FabianKlaffenboeck/Surron_UltraBee_Logger_Hardware/3dmodels/MP1584EN.step

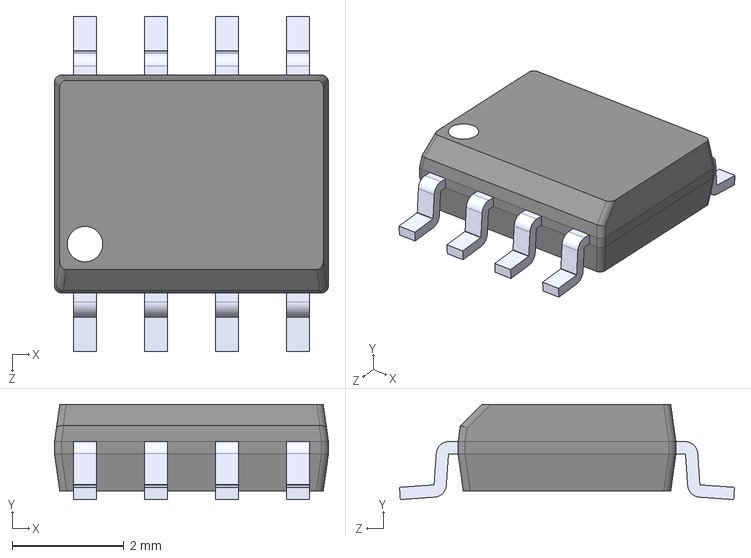
[picture p1: CAD file, 2024-06-30]
3dmodels/MP1584EN.step
4.90 x 1.70 x 5.99 mm
