FabianKlaffenboeck/Surron_UltraBee_Logger_Hardware/3dmodels/MP2637AGR-P--3DModel-STEP-269445.STEP

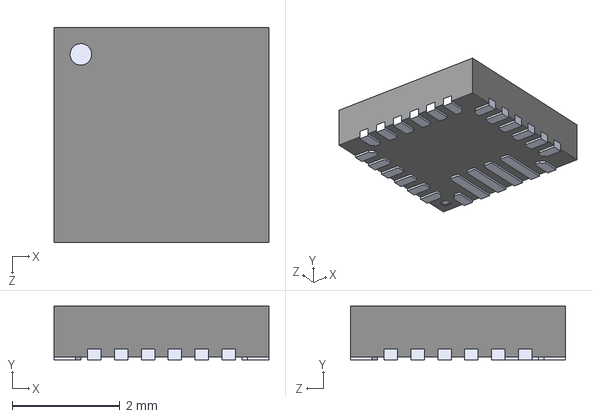
[picture p2: CAD file, 2024-05-28]
3dmodels/MP2637AGR-P--3DModel-STEP-269445.STEP
4.00 x 1.00 x 4.00 mm
