FabianKlaffenboeck/Surron_UltraBee_Logger_Hardware/3dmodels/SD-RSMT-2-MQ-WF.step

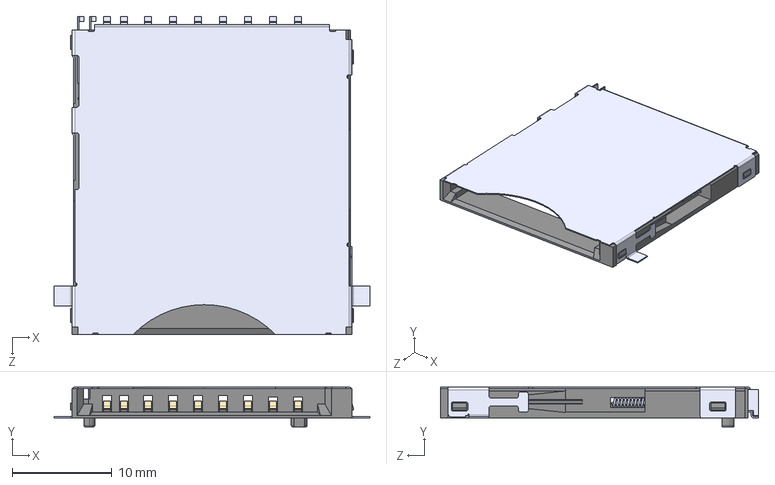
[picture p3: CAD file, 2024-05-28]
3dmodels/SD-RSMT-2-MQ-WF.step
31.6 x 4.00 x 31.9 mm
