FabianKlaffenboeck/Surron_UltraBee_Logger_Hardware/Hardware.kicad_pcb

## KiCad design Hardware.kicad_pcb (2024-08-03)

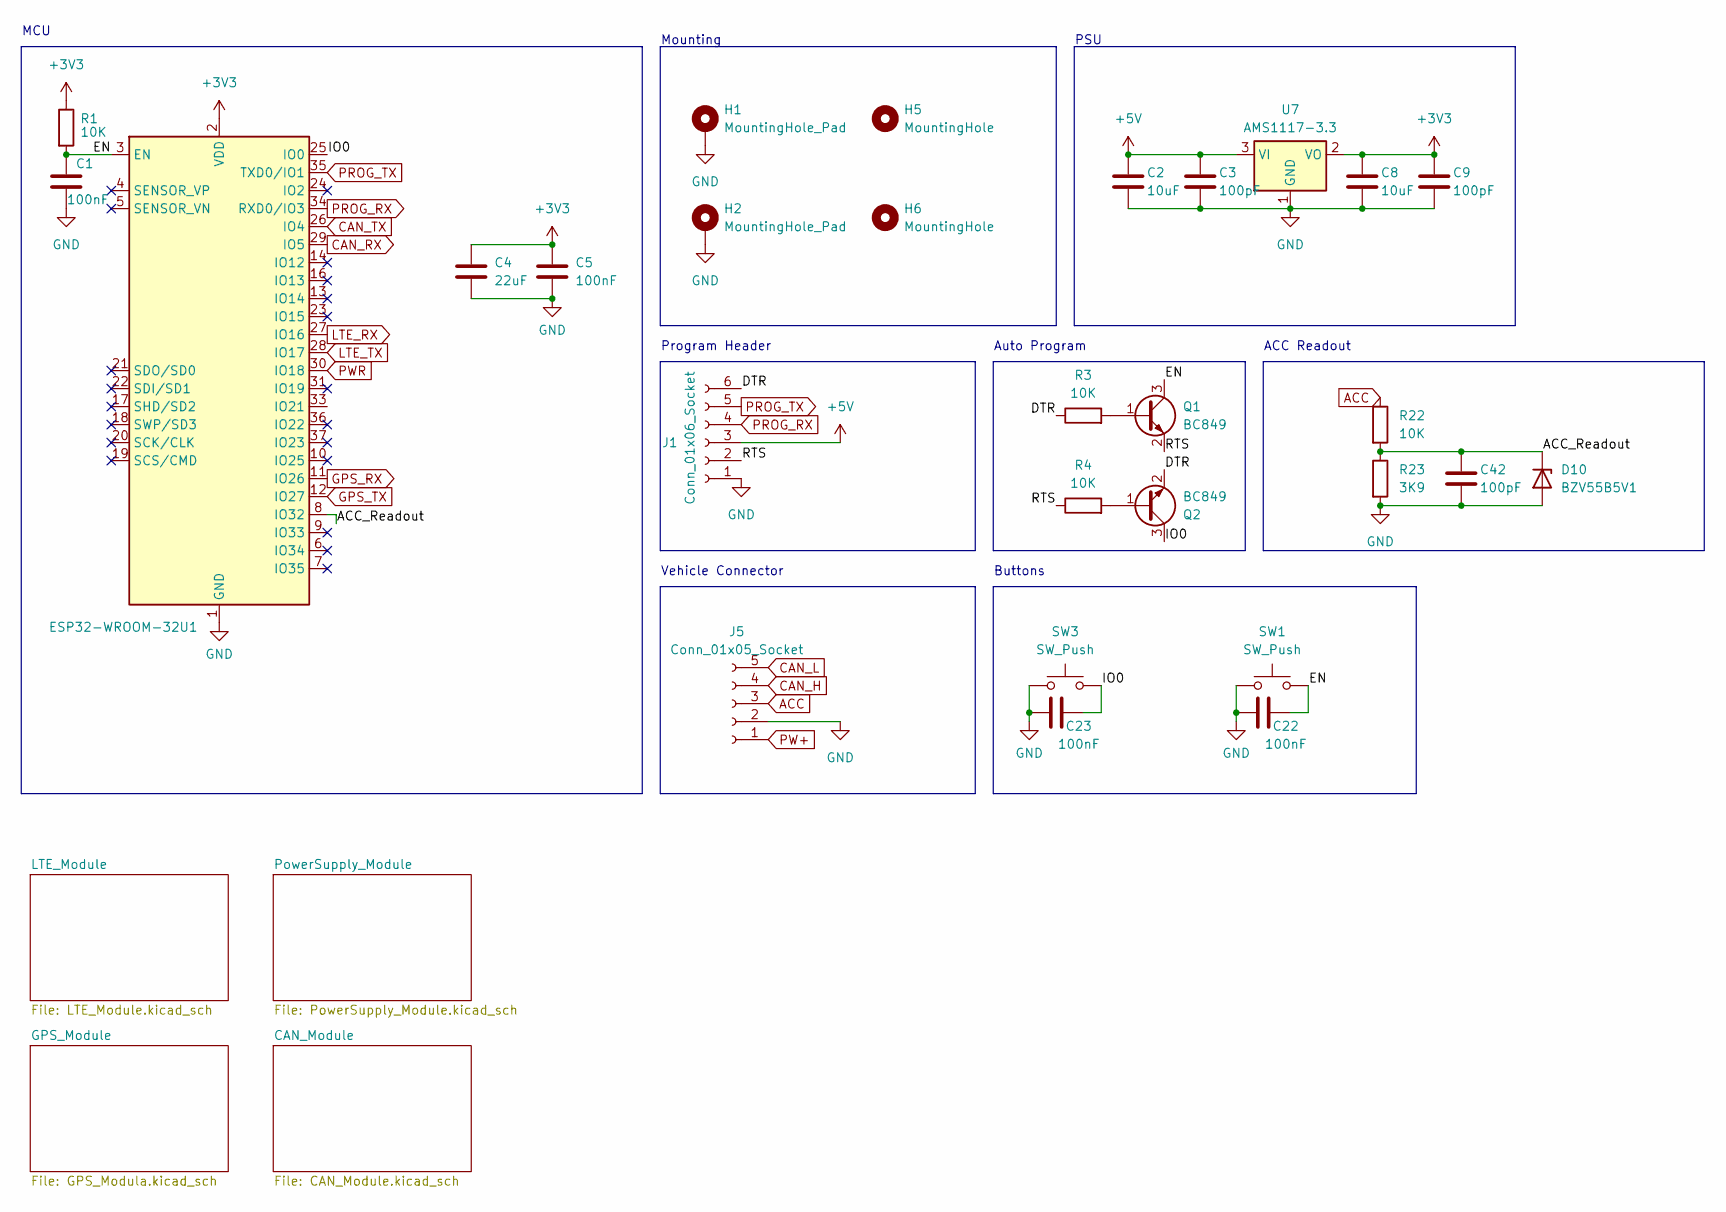
[picture p4: schematic Hardware.kicad_sch]

Parts:
C1, C5, C22, C23: 100nF; C_0805_2012Metric
C2, C8: 10uF; C_1206_3216Metric
C3, C9, C42: 100pF; C_0805_2012Metric
C4: 22uF; C_0603_1608Metric
D10: BZV55B5V1; D_MiniMELF
H1, H2: MountingHole_Pad; MountingHole_3.2mm_M3_DIN965_Pad
H5, H6: MountingHole; MountingHole_3.2mm_M3
J1: Conn_01x06_Socket; PinHeader_1x06_P2.54mm_Vertical
J5: Conn_01x05_Socket; PinHeader_1x05_P2.54mm_Vertical
Q1, Q2: BC849; SOT-23
R1, R3, R4, R22: 10K; R_0603_1608Metric
R23: 3K9; R_0603_1608Metric
SW1, SW3: SW_Push; SolderJumper-2_P1.3mm_Open_RoundedPad1.0x1.5mm
U1: ESP32-WROOM-32
U7: AMS1117-3.3; SOT-223-3_TabPin2

Connections:
+3V3: C4.1, C5.1, C8.1, C9.1, R1.1, U1.2 (VDD), U7.2 (VO); also elsewhere on the board
+5V: C2.1, C3.1, J1.3, U7.3 (VI); also elsewhere on the board
/ACC_Readout: C42.1, D10.1 (K), R22.2, R23.1, U1.8 (IO32)
/DTR: J1.6, Q2.2 (E), R3.1
/EN: C1.1, C22.2, Q1.3 (C), R1.2, SW1.2, U1.3 (EN)
/IO0: C23.2, Q2.3 (C), SW3.2, U1.25 (IO0)
/RTS: J1.2, Q1.2 (E), R4.1
ACC: J5.3, R22.1
CAN_H: J5.4; also elsewhere on the board
CAN_L: J5.5; also elsewhere on the board
CAN_RX: U1.29 (IO5); also elsewhere on the board
CAN_TX: U1.26 (IO4); also elsewhere on the board
GND: C1.2, C2.2, C3.2, C4.2, C5.2, C8.2, C9.2, C22.1, C23.1, C42.2, D10.2 (A), H1.1, H2.1, J1.1, J5.2, R23.2, SW1.1, SW3.1, U1.1 (GND), U1.15 (GND), U1.38 (GND), U1.39 (GND), U7.1 (GND); also elsewhere on the board
GPS_RX: U1.11 (IO26); also elsewhere on the board
GPS_TX: U1.12 (IO27); also elsewhere on the board
LTE_RX: U1.27 (IO16); also elsewhere on the board
LTE_TX: U1.28 (IO17); also elsewhere on the board
unnamed: Q1.1 (B), R3.2
unnamed: Q2.1 (B), R4.2
PROG_RX: J1.4, U1.34 (RXD0/IO3)
PROG_TX: J1.5, U1.35 (TXD0/IO1)
PW+: J5.1; also elsewhere on the board
PWR: U1.30 (IO18); also elsewhere on the board

Notes on the sheet:
Buttons
Auto Program
Vehicle Connector
PSU
Mounting
Program Header
MCU
ACC Readout

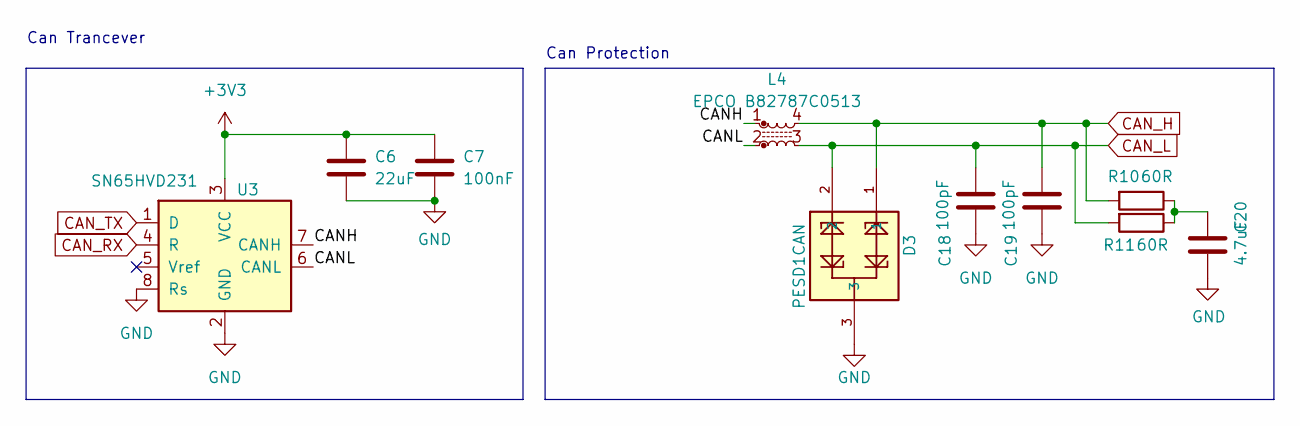
[picture p5: schematic CAN_Module.kicad_sch]

Parts:
C6: 22uF; C_0603_1608Metric
C7: 100nF; C_0805_2012Metric
C18, C19: 100pF; C_0805_2012Metric
C20: 4.7uF; C_0805_2012Metric
D3: PESD1CAN; SOT-23-3
L4: EPCO B82787C0513
R10, R11: 60R; R_0603_1608Metric
U3: SN65HVD231; SOIC-8_3.9x4.9mm_P1.27mm

Connections:
+3V3: C6.1, C7.1, U3.3 (VCC); also elsewhere on the board
/CAN_Module/CANH: L4.1, U3.7 (CANH)
/CAN_Module/CANL: L4.2, U3.6 (CANL)
CAN_H: C19.2, D3.1, L4.4, R10.2; also elsewhere on the board
CAN_L: C18.2, D3.2, L4.3, R11.2; also elsewhere on the board
CAN_RX: U3.4 (R); also elsewhere on the board
CAN_TX: U3.1 (D); also elsewhere on the board
GND: C6.2, C7.2, C18.1, C19.1, C20.2, D3.3, U3.2 (GND), U3.8 (Rs); also elsewhere on the board
unnamed: C20.1, R10.1, R11.1

Notes on the sheet:
Can Trancever
Can Protection

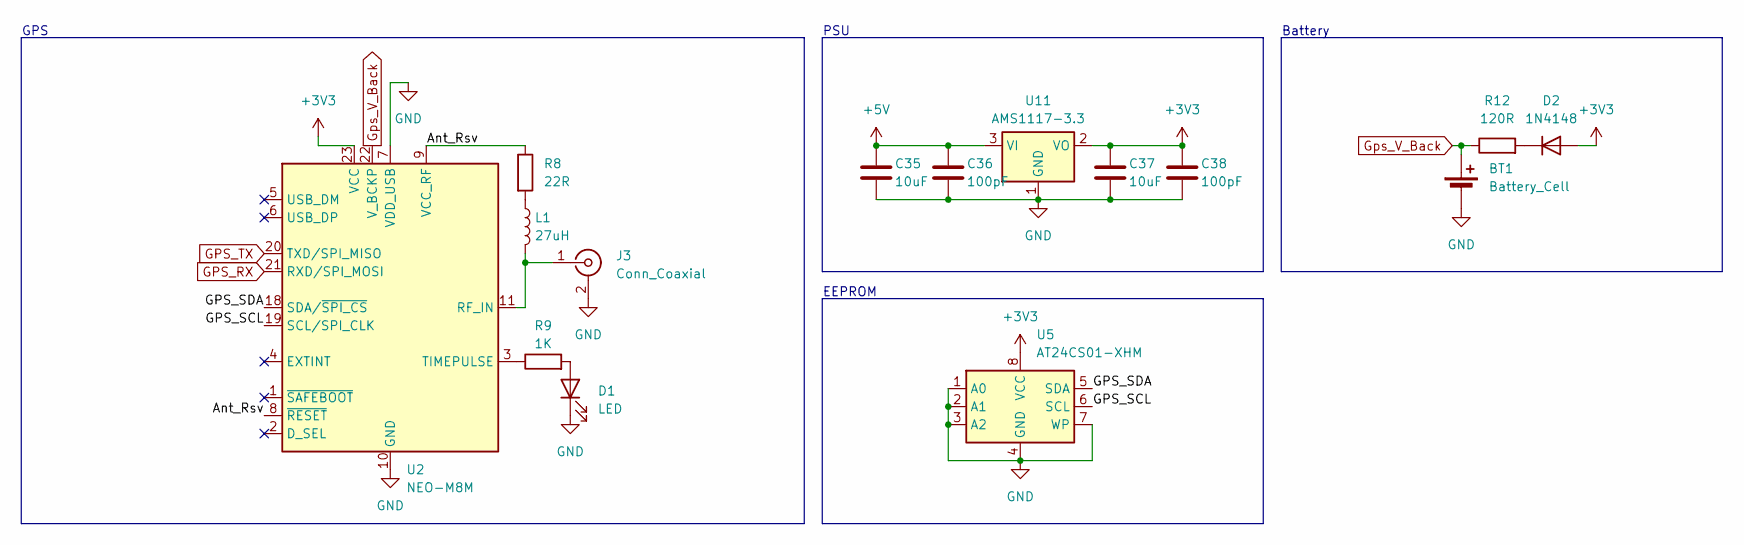
[picture p6: schematic GPS_Modula.kicad_sch]

Parts:
BT1: Battery_Cell; BatteryHolder_Seiko_MS621F
C35, C37: 10uF; C_1206_3216Metric
C36, C38: 100pF; C_0805_2012Metric
D1: LED; C_0603_1608Metric
D2: 1N4148; D_SOD-323
J3: Conn_Coaxial; U.FL_Molex_MCRF_73412-0110_Vertical
L1: 27uH; L_0805_2012Metric
R8: 22R; R_0603_1608Metric
R9: 1K; R_0603_1608Metric
R12: 120R; R_0603_1608Metric
U2: NEO-M8M; ublox_NEO
U5: AT24CS01-XHM; TSSOP-8_4.4x3mm_P0.65mm
U11: AMS1117-3.3; SOT-223-3_TabPin2

Connections:
+3V3: C37.1, C38.1, D2.2 (A), U2.23 (VCC), U5.8 (VCC), U11.2 (VO); also elsewhere on the board
+5V: C35.1, C36.1, U11.3 (VI); also elsewhere on the board
/GPS_Module/Ant_Rsv: R8.1, U2.8 (~RESET), U2.9 (VCC_RF)
/GPS_Module/GPS_SCL: U2.19 (SCL/SPI_CLK), U5.6 (SCL)
/GPS_Module/GPS_SDA: U2.18 (SDA/~SPI_CS), U5.5 (SDA)
GND: BT1.2 (-), C35.2, C36.2, C37.2, C38.2, D1.1 (K), J3.2 (Ext), U2.7 (VDD_USB), U2.10 (GND), U2.12 (GND), U2.13 (GND), U2.24 (GND), U5.1 (A0), U5.2 (A1), U5.3 (A2), U5.4 (GND), U5.7 (WP), U11.1 (GND); also elsewhere on the board
GPS_RX: U2.21 (RXD/SPI_MOSI); also elsewhere on the board
GPS_TX: U2.20 (TXD/SPI_MISO); also elsewhere on the board
Gps_V_Back: BT1.1 (+), R12.1, U2.22 (V_BCKP)
unnamed: D1.2 (A), R9.2
unnamed: D2.1 (K), R12.2
unnamed: J3.1 (In), L1.2, U2.11 (RF_IN)
unnamed: L1.1, R8.2
unnamed: R9.1, U2.3 (TIMEPULSE)

Notes on the sheet:
EEPROM
Battery
PSU
GPS

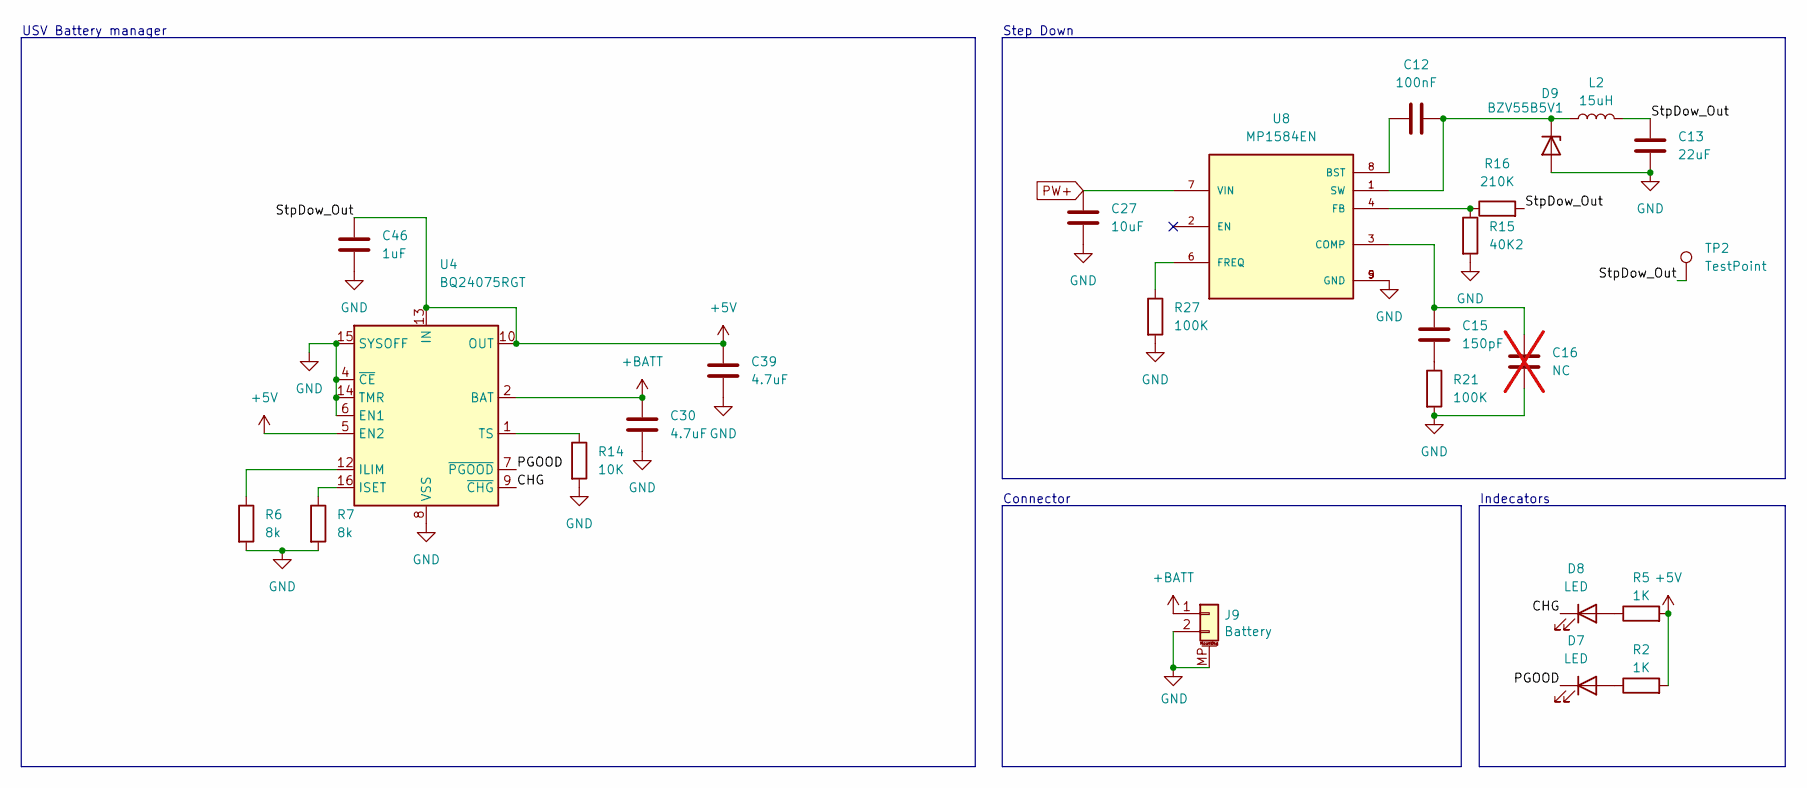
[picture p7: schematic PowerSupply_Module.kicad_sch]

Parts:
C12: 100nF; C_0805_2012Metric
C13: 22uF; C_0603_1608Metric
C15: 150pF; C_0603_1608Metric
C16: NC; C_0805_2012Metric; not fitted
C27: 10uF; C_1206_3216Metric
C30, C39: 4.7uF; C_0805_2012Metric
C46: 1uF; C_0603_1608Metric
D7, D8: LED; C_0603_1608Metric
D9: BZV55B5V1; D_MiniMELF
J9: Battery; JST_PH_S2B-PH-SM4-TB_1x02-1MP_P2.00mm_Horizontal
L2: 15uH; L_Abracon_ASPI-0630LR
R2, R5: 1K; R_0603_1608Metric
R6, R7: 8k; R_0603_1608Metric
R14: 10K; R_0603_1608Metric
R15: 40K2; R_0603_1608Metric
R16: 210K; R_0603_1608Metric
R21, R27: 100K; R_0603_1608Metric
TP2: TestPoint; TestPoint_Pad_D1.5mm
U4: BQ24075RGT; VQFN-16-1EP_3x3mm_P0.5mm_EP1.6x1.6mm
U8: MP1584EN; SOIC127P600X170-9N

Connections:
+5V: C13.1, C39.1, C46.1, L2.2, R2.2, R5.2, R16.2, TP2.1, U4.5 (EN2), U4.10 (OUT), U4.11 (OUT), U4.13 (IN); also elsewhere on the board
+BATT: C30.1, J9.1, U4.2 (BAT), U4.3 (BAT)
/PowerSupply_Module/CHG: D8.1 (K), U4.9 (~CHG)
/PowerSupply_Module/PGOOD: D7.1 (K), U4.7 (~PGOOD)
GND: C13.2, C16.1, C27.1, C30.2, C39.2, C46.2, D9.2 (A), J9.2, J9.MP (MountPin), R6.2, R7.2, R14.2, R15.2, R21.2, R27.2, U4.4 (~CE), U4.6 (EN1), U4.8 (VSS), U4.14 (TMR), U4.15 (SYSOFF), U4.17 (VSS), U8.5 (GND), U8.9 (GND); also elsewhere on the board
unnamed: C15.1, R21.1
unnamed: D7.2 (A), R2.1
unnamed: D8.2 (A), R5.1
unnamed: C12.2, D9.1 (K), L2.1, U8.1 (SW)
unnamed: R6.1, U4.12 (ILIM)
unnamed: R7.1, U4.16 (ISET)
unnamed: R14.1, U4.1 (TS)
unnamed: C12.1, U8.8 (BST)
unnamed: C15.2, C16.2, U8.3 (COMP)
unnamed: R15.1, R16.1, U8.4 (FB)
unnamed: R27.1, U8.6 (FREQ)
PW+: C27.2, U8.7 (VIN); also elsewhere on the board

Notes on the sheet:
USV Battery manager
Step Down
Connector
Indecators

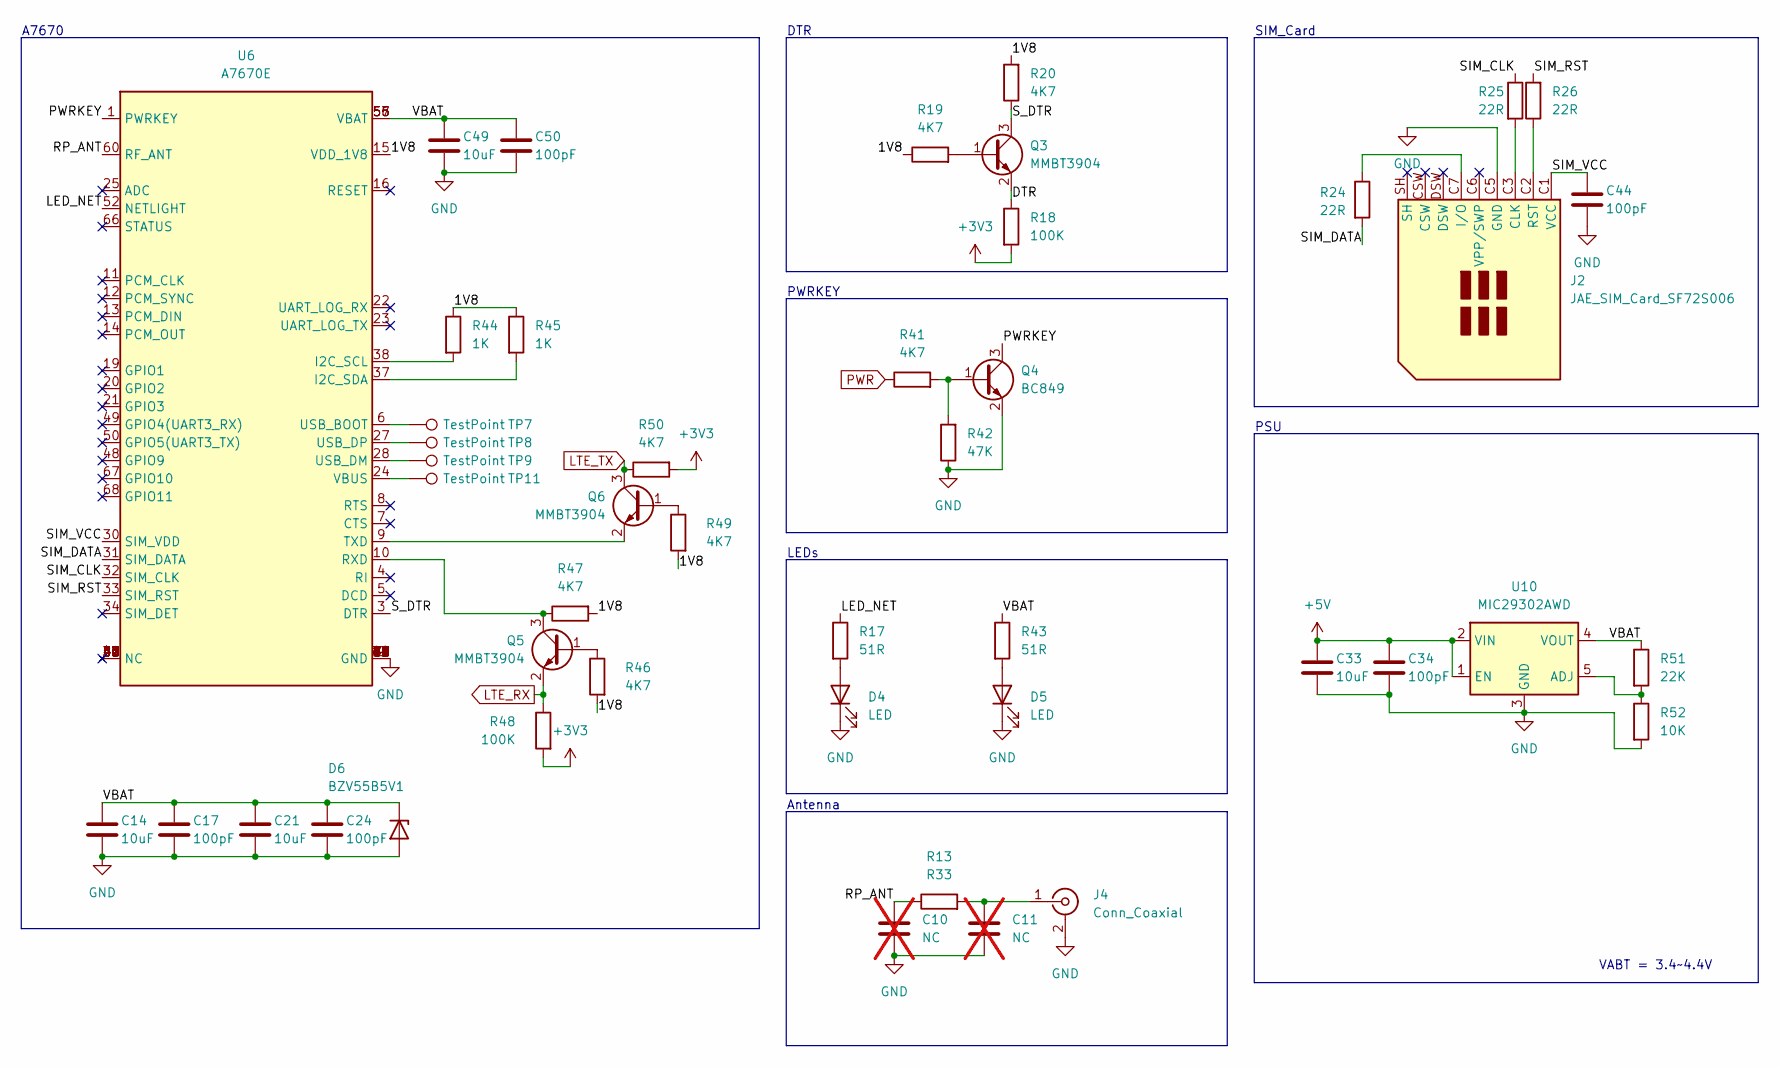
[picture p8: schematic LTE_Module.kicad_sch]

Parts:
C10, C11: NC; C_0805_2012Metric; not fitted
C14, C21, C33, C49: 10uF; C_1206_3216Metric
C17, C24, C34, C44, C50: 100pF; C_0805_2012Metric
D4, D5: LED; C_0603_1608Metric
D6: BZV55B5V1; D_MiniMELF
J2: JAE_SIM_Card_SF72S006
J4: Conn_Coaxial; U.FL_Molex_MCRF_73412-0110_Vertical
Q3, Q5, Q6: MMBT3904; SOT-23
Q4: BC849; SOT-23
R13: R33; R_0603_1608Metric
R17, R43: 51R; R_0603_1608Metric
R18, R48: 100K; R_0603_1608Metric
R19, R20, R41, R46, R47, R49, R50: 4K7; R_0603_1608Metric
R24, R25, R26: 22R; R_0603_1608Metric
R42: 47K; R_0603_1608Metric
R44, R45: 1K; R_0603_1608Metric
R51: 22K; R_0603_1608Metric
R52: 10K; R_0603_1608Metric
TP7, TP8, TP9, TP11: TestPoint; TestPoint_Pad_D1.5mm
U6: A7670E
U10: MIC29302AWD; TO-252-5_TabPin3

Connections:
+3V3: R18.2, R48.2, R50.2; also elsewhere on the board
+5V: C33.1, C34.1, U10.1 (EN), U10.2 (VIN); also elsewhere on the board
/LTE_Module/1V8: R19.1, R20.2, R44.1, R45.1, R46.2, R47.2, R49.2, U6.15 (VDD_1V8)
/LTE_Module/DTR: Q3.2 (E), R18.1
/LTE_Module/LED_NET: R17.1, U6.52 (NETLIGHT)
/LTE_Module/PWRKEY: Q4.3 (C), U6.1 (PWRKEY)
/LTE_Module/RP_ANT: C10.1, R13.1, U6.60 (RF_ANT)
/LTE_Module/SIM_CLK: R25.1, U6.32 (SIM_CLK)
/LTE_Module/SIM_DATA: R24.2, U6.31 (SIM_DATA)
/LTE_Module/SIM_RST: R26.2, U6.33 (SIM_RST)
/LTE_Module/SIM_VCC: C44.1, J2.C1 (VCC), U6.30 (SIM_VDD)
/LTE_Module/S_DTR: Q3.3 (C), R20.1, U6.3 (DTR)
/LTE_Module/VBAT: C14.1, C17.1, C21.1, C24.1, C49.1, C50.1, D6.1 (K), R43.1, R51.1, U6.55 (VBAT), U6.56 (VBAT), U6.57 (VBAT), U10.4 (VOUT)
GND: C10.2, C11.2, C14.2, C17.2, C21.2, C24.2, C33.2, C34.2, C44.2, C49.2, C50.2, D4.1 (K), D5.1 (K), D6.2 (A), J2.C5 (GND), J4.2 (Ext), Q4.2 (E), R42.1, R52.2, U6.2 (GND), U6.17 (GND), U6.18 (GND), U6.29 (GND), U6.39 (GND), U6.45 (GND), U6.46 (GND), U6.54 (GND), U6.58 (GND), U6.59 (GND), U6.61 (GND), U6.62 (GND), U6.63 (GND), U6.64 (GND), U6.65 (GND), U6.69 (GND), U6.70 (GND), U6.71 (GND), U6.72 (GND), U6.73 (GND), U6.74 (GND), U6.75 (GND), U6.76 (GND), U6.77 (GND), U6.78 (GND), U6.79 (GND), U6.80 (GND), U6.81 (GND), U6.82 (GND), U6.83 (GND), U6.84 (GND), U6.85 (GND), U6.86 (GND), U6.87 (GND), U6.88 (GND), U10.3 (GND); also elsewhere on the board
LTE_RX: Q5.2 (E), R48.1; also elsewhere on the board
LTE_TX: Q6.3 (C), R50.1; also elsewhere on the board
unnamed: D4.2 (A), R17.2
unnamed: D5.2 (A), R43.2
unnamed: J2.C3 (CLK), R25.2
unnamed: J2.C7 (I/O), R24.1
unnamed: J2.C2 (RST), R26.1
unnamed: C11.1, J4.1 (In), R13.2
unnamed: Q3.1 (B), R19.2
unnamed: Q4.1 (B), R41.2, R42.2
unnamed: Q5.1 (B), R46.1
unnamed: Q5.3 (C), R47.1, U6.10 (RXD)
unnamed: Q6.1 (B), R49.1
unnamed: Q6.2 (E), U6.9 (TXD)
unnamed: R44.2, U6.38 (I2C_SCL)
unnamed: R45.2, U6.37 (I2C_SDA)
unnamed: TP7.1, U6.6 (USB_BOOT)
unnamed: TP9.1, U6.28 (USB_DM)
unnamed: TP8.1, U6.27 (USB_DP)
unnamed: TP11.1, U6.24 (VBUS)
unnamed: R51.2, R52.1, U10.5 (ADJ)
PWR: R41.1; also elsewhere on the board

Notes on the sheet:
PWRKEY
A7670
DTR
PSU
LEDs
SIM_Card
Antenna
VABT = 3.4~4.4V

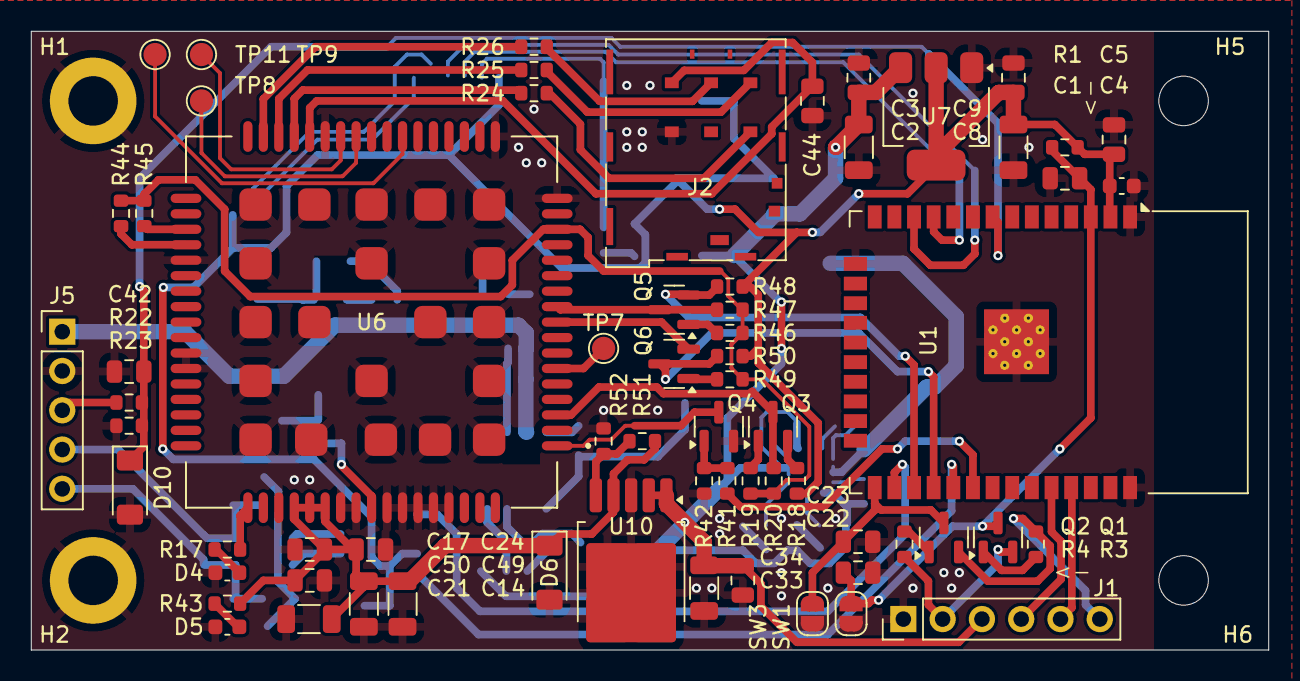
[picture p9: board Hardware.kicad_pcb from above]

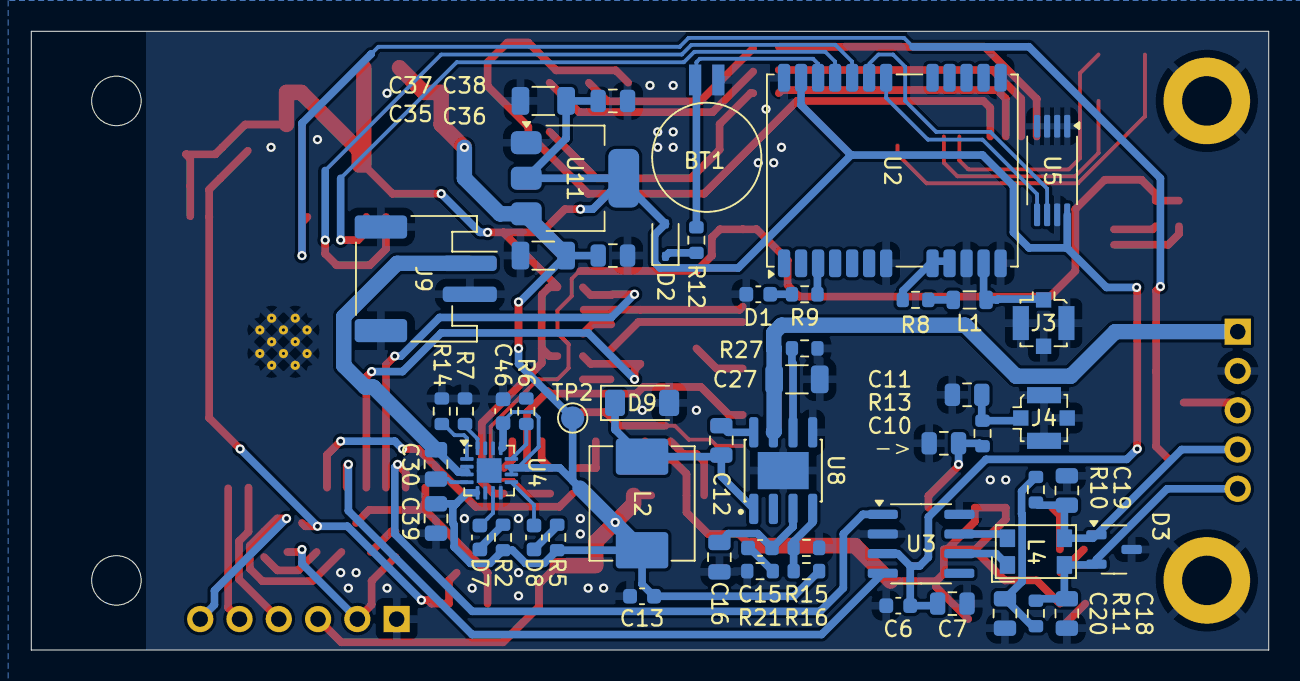
[picture p10: board Hardware.kicad_pcb from below]

Board: 2 copper layers, 80.0 x 40.0 mm, 124 parts (54 on the bottom side), 79 nets.
