FabianKlaffenboeck/Surron_UltraBee_Logger_Hardware/(commit log)

2024-04-01 added files for Kibot
    [Hardware.kicad_pcb]
2024-04-05 added scematics for gps and sd reader
    [Hardware.kicad_pcb, Hardware.kicad_sch]
2024-04-07 mostly finisged scematics
    [Hardware.kicad_sch]
2024-04-09 done some layouting
    [Hardware.kicad_sch]
2024-04-09 added testpoints
    [Hardware.kicad_sch]
2024-04-10 moved everythint into hirachical sheets
    [CAN_Module.kicad_sch, GPS_Modula.kicad_sch, Hardware.kicad_sch, LTE_Module.kicad_sch, SD_Modula.kicad_sch]
2024-04-10 fixed layout
    [GPS_Modula.kicad_sch, Hardware.kicad_sch, LTE_Module.kicad_sch]
2024-04-10 added psu and formated board outline
    [CAN_Module.kicad_sch, GPS_Modula.kicad_sch, Hardware.kicad_pcb, Hardware.kicad_sch, LTE_Module.kicad_sch, SD_Modula.kicad_sch]
2024-04-10 added charging footprint
    [Hardware.kicad_sch, LTE_Module.kicad_sch, PowerSupply_Module.kicad_sch]
2024-04-11 added power layout
    [PowerSupply_Module.kicad_sch]
2024-04-11 added step down
    [PowerSupply_Module.kicad_sch]
2024-05-15 added footprint for a7670e
    [CAN_Module.kicad_sch, GPS_Modula.kicad_sch, Hardware.kicad_sch, LTE_Module.kicad_sch, SD_Modula.kicad_sch]
2024-05-20 done most of the schematics
    [CAN_Module.kicad_sch, GPS_Modula.kicad_sch, Hardware.kicad_sch, LTE_Module.kicad_sch, PowerSupply_Module.kicad_sch, SD_Modula.kicad_sch]
2024-05-20 done refacoring
    [CAN_Module.kicad_sch, GPS_Modula.kicad_sch, Hardware.kicad_sch, LTE_Module.kicad_sch, PowerSupply_Module.kicad_sch, SD_Modula.kicad_sch]
2024-05-28 assigned most footprints
    [CAN_Module.kicad_sch, GPS_Modula.kicad_sch, Hardware.kicad_sch, LTE_Module.kicad_sch, MP2637AGR-P--3DModel-STEP-269445.STEP, PowerSupply_Module.kicad_sch, SD-RSMT-2-MQ-WF.step, SD_Modula.kicad_sch]
2024-05-31 cleaned up scematics and updated power management
    [CAN_Module.kicad_sch, GPS_Modula.kicad_sch, Hardware.kicad_sch, LTE_Module.kicad_sch, PowerSupply_Module.kicad_sch, SD_Modula.kicad_sch]
2024-05-31 finelized scematics
    [CAN_Module.kicad_sch, GPS_Modula.kicad_sch, Hardware.kicad_pcb, Hardware.kicad_sch, LTE_Module.kicad_sch, PowerSupply_Module.kicad_sch, SD_Modula.kicad_sch]
2024-06-01 mostly layouted
    [CAN_Module.kicad_sch, GPS_Modula.kicad_sch, Hardware.kicad_pcb, Hardware.kicad_sch, LTE_Module.kicad_sch, PowerSupply_Module.kicad_sch, SD_Modula.kicad_sch]
2024-06-01 pre remobing sd card
    [CAN_Module.kicad_sch, GPS_Modula.kicad_sch, Hardware.kicad_pcb, Hardware.kicad_sch, LTE_Module.kicad_sch, SD_Modula.kicad_sch]
2024-06-02 mostly finished layout
    [Hardware.kicad_pcb, Hardware.kicad_sch, LTE_Module.kicad_sch]
2024-06-23 switchen can supply to 3v3
    [CAN_Module.kicad_sch, GPS_Modula.kicad_sch, Hardware.kicad_pcb]
2024-06-30 updated schematics:
    Fixed bug with PWKEY of LTE module
    Fixed big with power
    [Hardware.kicad_pcb, Hardware.kicad_sch, LTE_Module.kicad_sch, MP1584EN.step, PowerSupply_Module.kicad_sch]
2024-07-02 first new layout
    [CAN_Module.kicad_sch, GPS_Modula.kicad_sch, Hardware.kicad_pcb, Hardware.kicad_sch, LTE_Module.kicad_sch, PowerSupply_Module.kicad_sch]
2024-07-02 cleaned up
    [Hardware.kicad_pcb]
2024-07-02 cleaned silkscreen
    [Hardware.kicad_pcb]
2024-07-02 fixed drc
    [Hardware.kicad_pcb]
2024-08-03 cahnged resistor value for charing current
    [Hardware.kicad_pcb, PowerSupply_Module.kicad_sch]
